aechen/HydraulicControlSystem/BOM.xlsx

 |  | Quantity | Component | Vendor Link | Fabrication Files | Description
ELECTRONICS | PCB | 1 | Bare PCB | JLCPCB / PCBWay
 |  | 1 | Arduino Nano ESP32 | Arduino (https://store-usa.arduino.cc/products/nano-esp32) | -
 |  | 3 | XT30 Connector | Amazon (https://www.amazon.com/10Pairs-Upgrade-Connector-Female-Battery/dp/B08P5HVMYT) | -
 |  | 1 | XT60 Connector | Amazon (https://www.amazon.com/dp/B09XTN9N9S?ref_=ppx_hzsearch_conn_dt_b_fed_asin_title_2) | -
 |  | 1 | Voltage Regulator | Polou (https://www.pololu.com/product/2890) | - | 4.5-20V Fine-Adjust Step-Up Voltage Regulator U3V70A
 |  |  | Header Pins | Amazon (https://www.amazon.com/Breakaway-Header-Straight-Connector-Prototype/dp/B07BXDYTBP?s=electronics) | - | 0.1" (2.54 mm) male pin headers
 |  | 2 | Led Lights | Amazon (https://www.amazon.com/BOJACK-Lighting-Electronics-Components-Emitting/dp/B09XDMJ6KY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) | -
 |  | 3 | Jumper Pins | Amazon (https://www.amazon.com/California-JOS-Standard-Circuit-Connection/dp/B0BRK36G33) | -
 |  | 2 | Resistors | Amazon (https://www.amazon.com/BOJACK-Values-Resistor-Resistors-Assortment/dp/B08FD1XVL6) | - | 330 ohm
 |  | 6 | Capacitors | Amazon (https://www.amazon.com/ALLECIN-Monolithic-Ceramic-Capacitor-Kit/dp/B0C1V8Q93P?cv_ct_cx=capacitors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) | - | 3 - 47 nF(473), 3 - 10 microF(106)
 |  | 1 | Toggle Switch | DigiKey (https://www.digikey.com/en/products/detail/c-k/E101SD1CGE/484034) | - | E101SD1CGE
 | Others | 3 | RPM Sensor | HobbyTown (https://www.hobbytown.com/hobbywing-rpm-sensor-hwa86060041/p453341) | -
 |  | 3 | Pumps | TCS Micropumps (https://micropumps.co.uk/micro-gear-pumps-mg-series/) | - | MGD1000F Micro-gear Pumps
 |  | 3 | ESC | Amazon (https://www.amazon.com/dp/B08HWQ58QX?ref_=ppx_hzsearch_conn_dt_b_fed_asin_title_3&th=1) | - | Readytosky Bidirectional 40A Brushless ESC 2-6S UBEC 3A 5V
 |  | 1 | Lipo Battery | Amazon (https://www.amazon.com/dp/B09CTQ6H8S?ref_=ppx_hzsearch_conn_dt_b_fed_asin_title_1&th=1) | - | 11.1 V 120C 1500mAh 3S RC Battery
ENCLOSURE |  | 1 | Enclosure Lid | - | STLs/Enclosure_Lid
 |  | 1 | Enclosure Body | - | STLs/Enclosure_Body
 |  | 4 | Toggle Latch Hook | - | STLs/Toggle_Latch_Hook
 |  | 4 | Toggle Latch Arm | - | STLs/Toggle_Latch_Arm
 |  | 1 | Electronics Plate | - | STLs/Electronics_Plate
 |  | 1 | Battery Cover | - | STLs/Battery_Cover
 |  | 1 | Front Pump Tray | - | STLs/Front_Pump_Tray
 |  | 1 | Back Pump Tray | - | STLs/Back_Pump_Tray
 |  | 1 | Gasket | McMaster-Carr (https://www.mcmaster.com/90025K616/) | - | X-Profile Oil Resistant Buna-N O-Ring
 |  | 3 | Cable Penetrators | Blue Robotics (https://bluerobotics.com/store/cables-connectors/penetrators/penetrator-vp/) | - | M6 thread, for 4-5mm cable
