aechen/HydraulicControlSystem/STLs/Enclosure_Body.STL

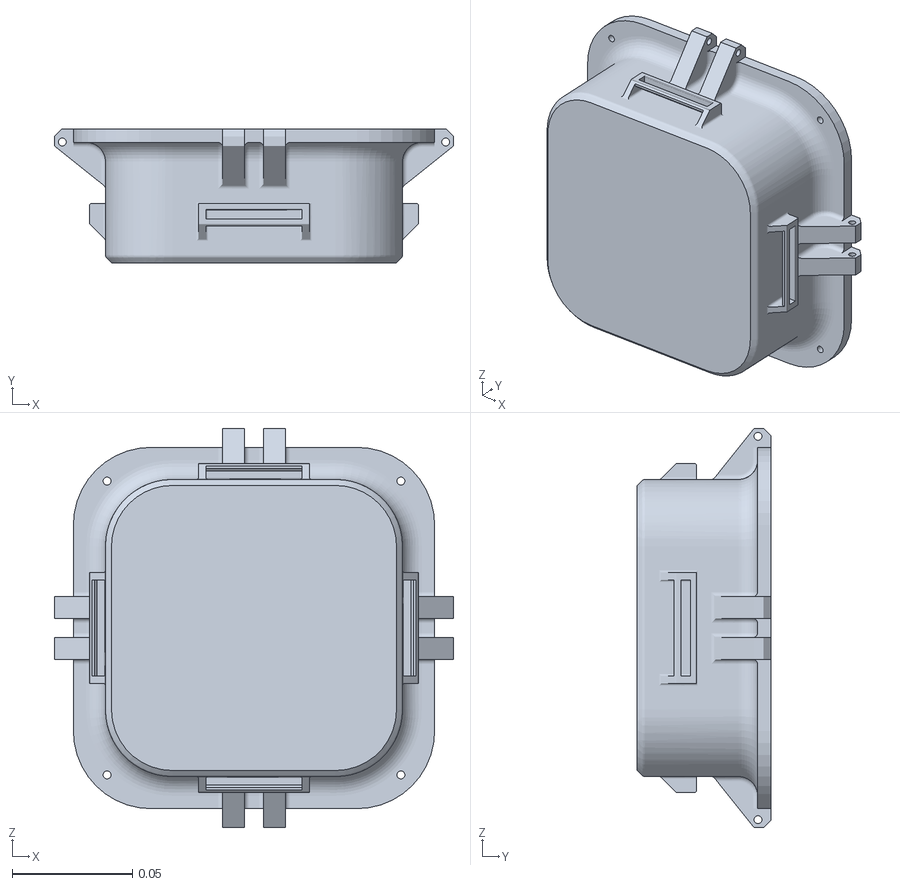
[picture p1: CAD file, 2026-11-11]
STLs/Enclosure_Body.STL
0.166 x 0.0555 x 0.166
