aechen/HydraulicControlSystem/STLs/Battery_Cover.STL

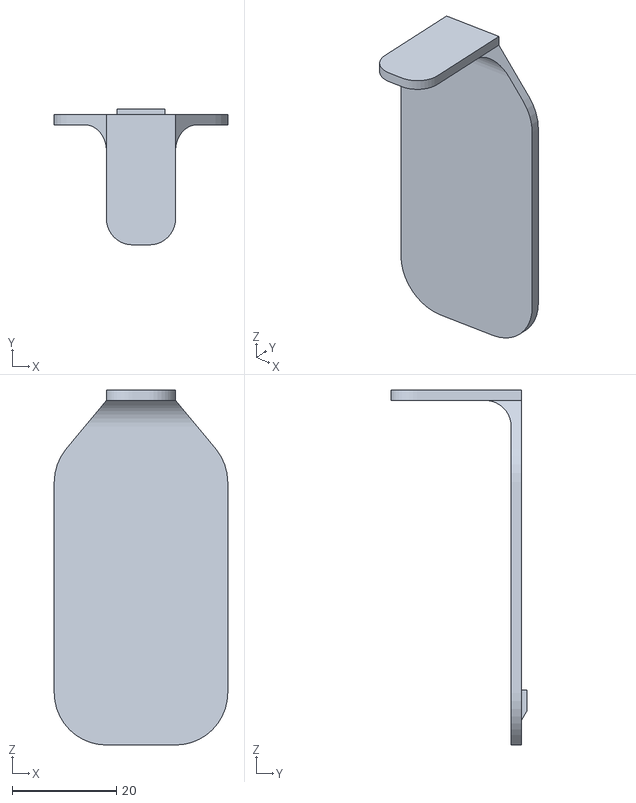
[picture p2: CAD file, 2025-11-18]
STLs/Battery_Cover.STL
33.2 x 26.0 x 68.0
