aechen/HydraulicControlSystem/STLs/Toggle_Latch_Arm.STL

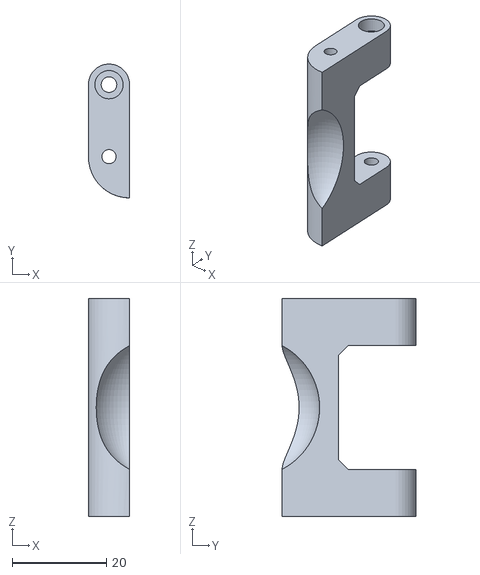
[picture p3: CAD file, 2025-11-18]
STLs/Toggle_Latch_Arm.STL
8.75 x 28.4 x 46.2
