aechen/HydraulicControlSystem/STLs/Toggle_Latch_Hook.STL

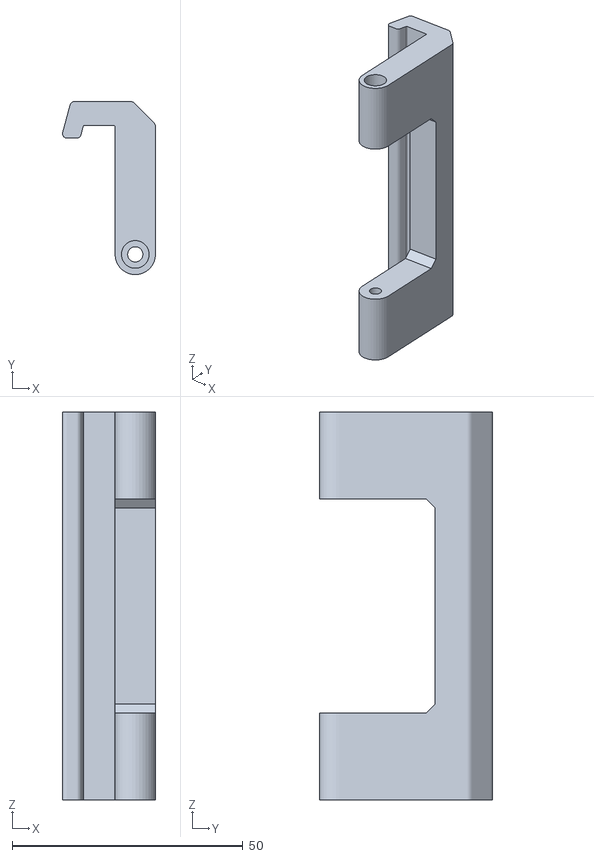
[picture p4: CAD file, 2025-11-18]
STLs/Toggle_Latch_Hook.STL
20.1 x 37.5 x 84.0
