aechen/HydraulicControlSystem/STLs/Enclosure_Lid.STL

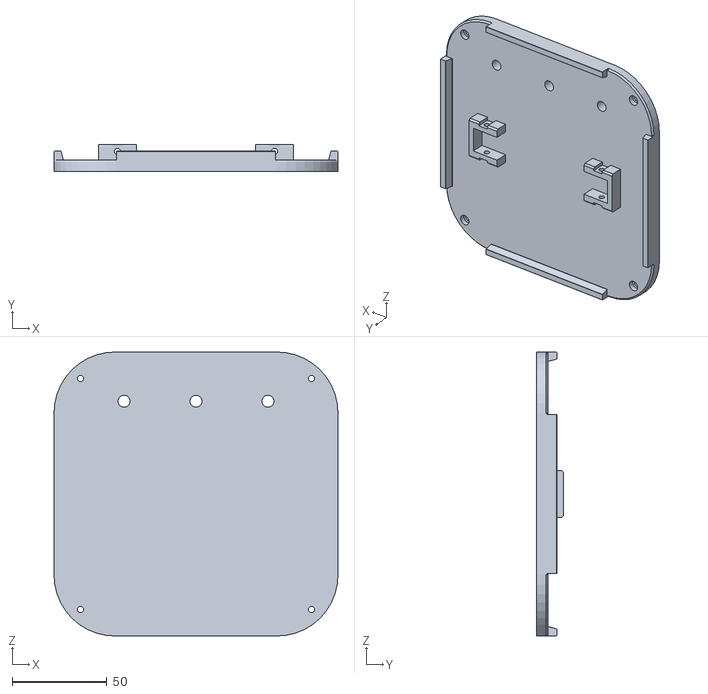
[picture p5: CAD file, 2025-11-18]
STLs/Enclosure_Lid.STL
150.0 x 14.0 x 150.0
