aechen/HydraulicControlSystem/STLs/Electronics_Plate.STL

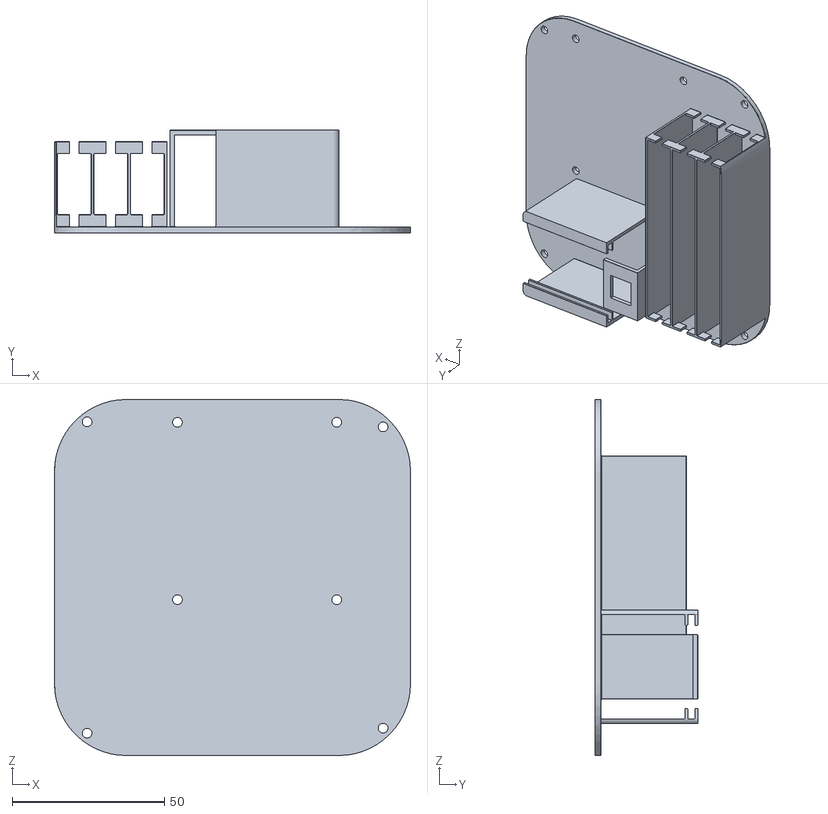
[picture p6: CAD file, 2025-11-18]
STLs/Electronics_Plate.STL
117.0 x 33.8 x 117.0
