aechen/HydraulicControlSystem/STLs/Turtle_Shell.STL

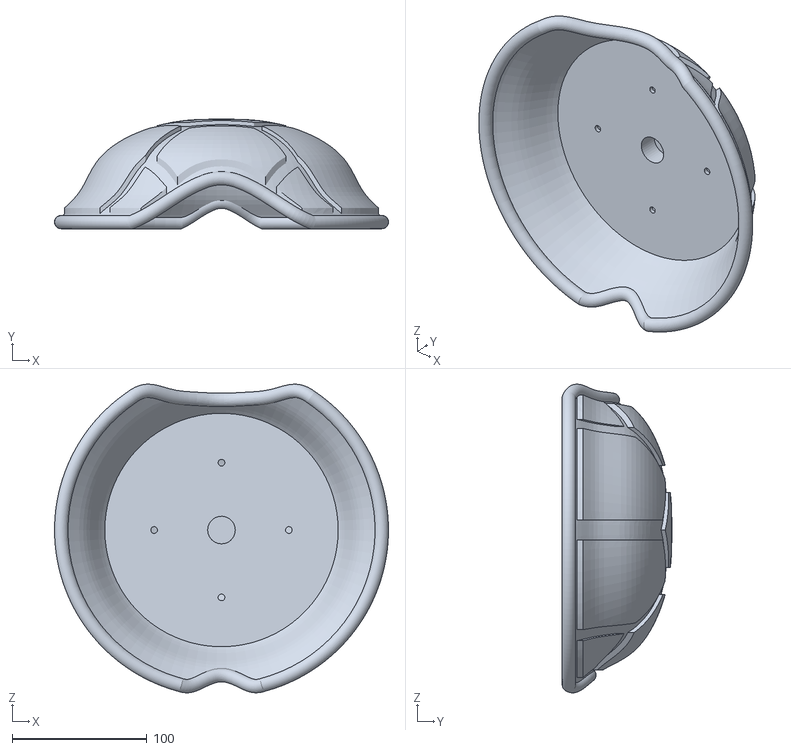
[picture p7: CAD file, 2025-11-18]
STLs/Turtle_Shell.STL
247.9 x 81.3 x 229.1
