aechen/HydraulicControlSystem/STLs/Turtle_Shell_Insert.STL

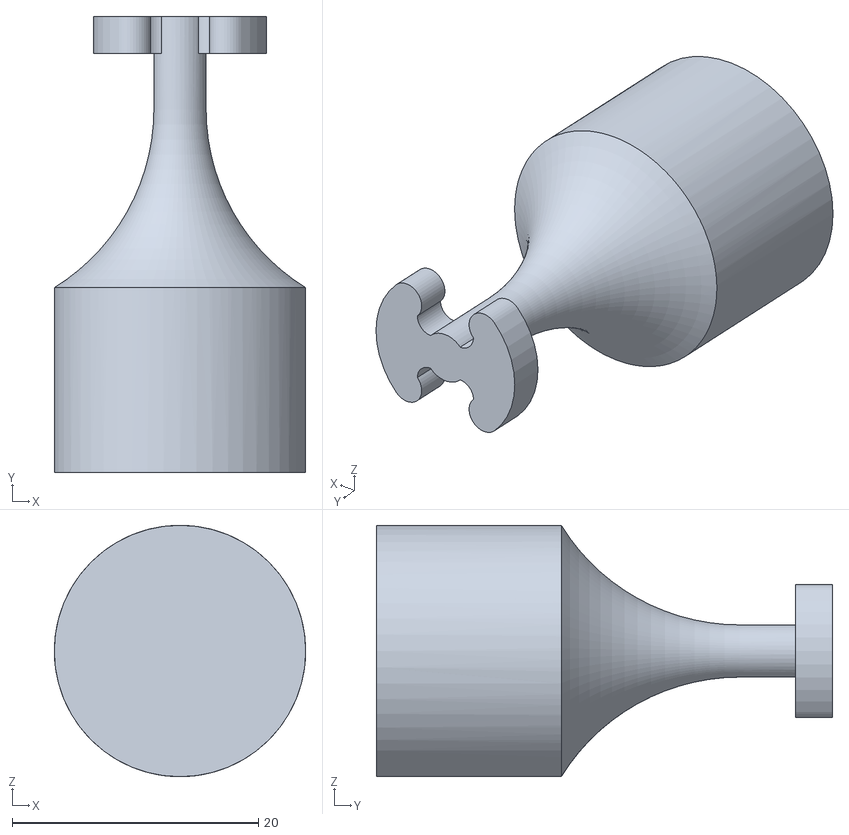
[picture p8: CAD file, 2025-11-18]
STLs/Turtle_Shell_Insert.STL
20.4 x 37.0 x 20.4
