aechen/HydraulicControlSystem/STLs/Back_Pump_Tray.STL

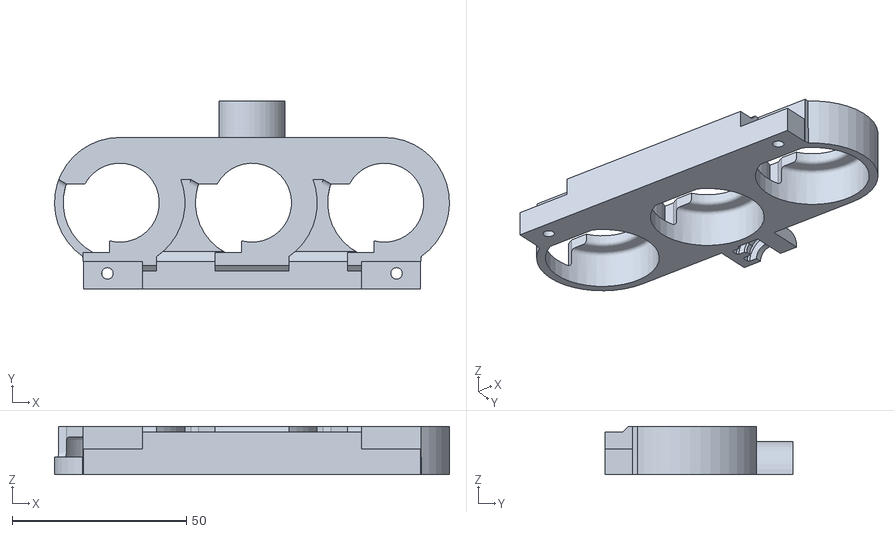
[picture p9: CAD file, 2025-11-18]
STLs/Back_Pump_Tray.STL
113.5 x 54.1 x 13.8
