aechen/HydraulicControlSystem/STLs/Front_Pump_Tray.STL

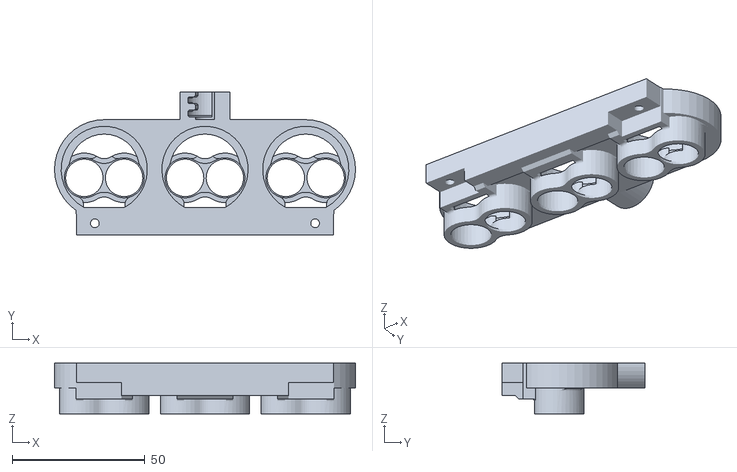
[picture p10: CAD file, 2025-11-18]
STLs/Front_Pump_Tray.STL
113.5 x 54.1 x 19.2
