aechen/HydraulicControlSystem/GerberFiles/CAMOutputs/Assembly/hydraulic_cb_version_2.3.txt

Partlist exported from C:/Users/chena/OneDrive/Documents/EAGLE/projects/hydraulic_cb/hydraulic_cb_rc_esc/hydraulic_cb_version_2.3.sch at 10/9/2024 4:53 PM

Qty Value         Device                Package       Parts                                                                              Description                                                                                                     AVAILABILITY DESCRIPTION                       HEIGHT     MANUFACTURER_NAME MANUFACTURER_PART_NUMBER MF      MP         PACKAGE POPULARITY      PRICE PROD_ID             PURCHASE-URL                                                TME_ELECTRONIC_COMPONENTS_PART_NUMBER TME_ELECTRONIC_COMPONENTS_PRICE-STOCK VALUE        
6                 C2.5/2                C2.5-2        C4_1, C5_1, C6_105, C7_153, C8_47, C9_153                                          CAPACITOR                                                                                                                                                                                                                                       28                                                                                                                                                                                             
3                 CONN_02               1X02          5V_CONN, I2C, VOUT_CONN                                                            Multi connection point. Often used as Generic Header-pin footprint for 0.1 inch spaced/style header connections                                                                                                                                                                                                                                                                                                                                
2                 LED5MM                LED_5MM       LED_5V, LED_VOUT                                                                   LED (Generic)                                                                                                                                                                                                                                                                                                                                                                                                                                  
2                 RESISTORAXIAL-0.3-KIT AXIAL-0.3-KIT R1, R2                                                                             Generic Resistor Package                                                                                                                                                                                                                                                                                                                                                                                                                       
9   455-1750-1-ND CONN_03               1X03          ESC1, ESC1_5V, ESC2, ESC2_5V, ESC3, ESC3_5V, RPM_SENSOR1, RPM_SENSOR2, RPM_SENSOR3 Multi connection point. Often used as Generic Header-pin footprint for 0.1 inch spaced/style header connections                                                                                                                                                       XXX-00000                                                                                                                                                   455-1750-1-ND
1   E101SD1CGE    E101SD1CGE            SW_E101SD1CGE SWITCH                                                                             Toggle Switch SPDT Through Hole Check availability                                                              In Stock      Toggle Switch SPDT Through Hole                                                        C&K     E101SD1CGE None                    None                      https://pricing.snapeda.com/search/part/E101SD1CGE/?ref=eda                                                                                          
1   NANO          NANO                  NANO          U$7                                                                                Arduino Nano                                                                                                                                                                                                                                                                                                                                                                                                                                   
1   U3V70F12      U3V70F12              U3V70F12      U$1                                                                                                                                                                                                                                                                                                                                                                                                                                                                                                                               
3   XT30U-M       XT30U-M               XT30U-M       U$5, U$6, U$8                                                                                                                                                                                                                                                                                                                                                                                                                                                                                                                     
1   XT60PW-M      XT60PW-M              XT60PWM       XT60                                                                               Socket; DC supply; XT60; male; PIN: 2; on PCBs; THT; Colour: yellow                                                          Socket                             DC supply  XT60              male                     PIN: 2  on PCBs    THT     Colour: yellow 8.4mm Changzou Amass Elec XT60PW-M
