aechen/HydraulicControlSystem/(commit log)

2025-11-18 added STL files
    [Back_Pump_Tray.STL, Battery_Cover.STL, Electronics_Plate.STL, Enclosure_Body.STL, Enclosure_Lid.STL, Front_Pump_Tray.STL, Toggle_Latch_Arm.STL, Toggle_Latch_Hook.STL]
2025-11-18 added Gerber files for PCB fabrication
    [copper_bottom.gbr, copper_top.gbr, drill_1_16.xln, gerber_job.gbrjob, profile.gbr, silkscreen_bottom.gbr, silkscreen_top.gbr, soldermask_bottom.gbr]
2025-11-18 added Arduino Code
2025-11-18 added BOM
    [BOM.xlsx]
2025-11-20 added Assembly Instruction Manual
2026-11-11 replace incorrect STL file with corrected version
